mattsousaa/projeto_revELA/03_esquematicos_circuitos/01_projetoCompleto.PDF

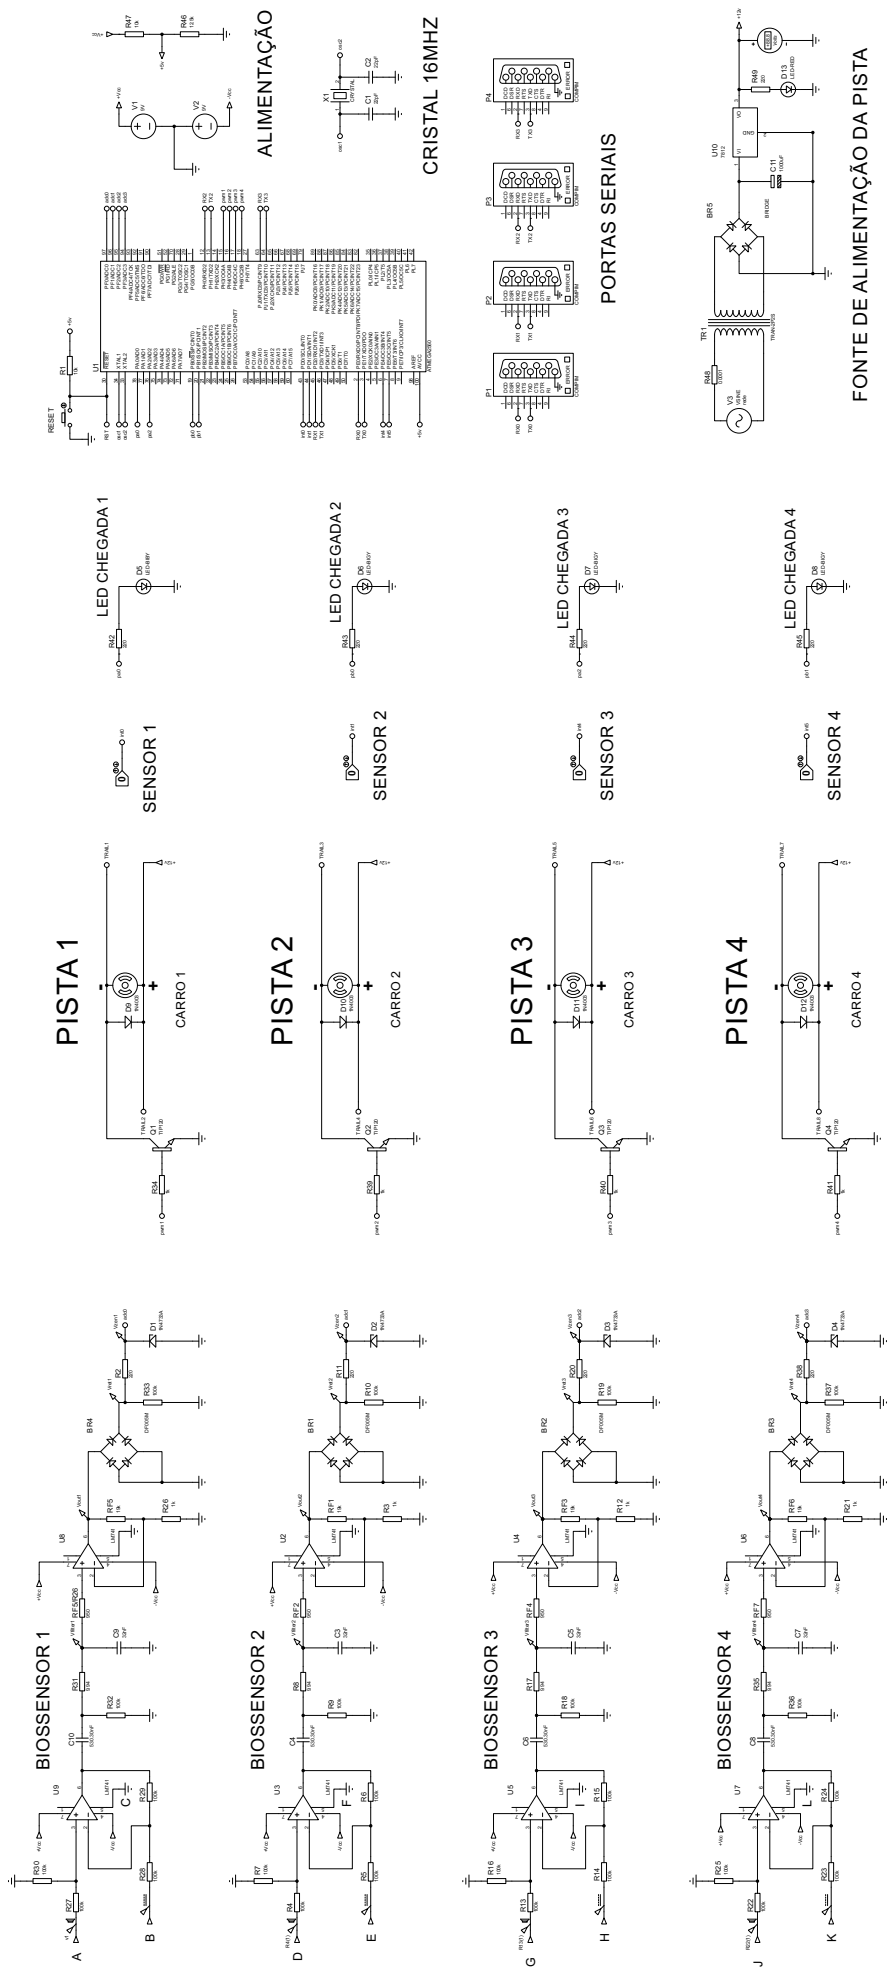
[picture p34: page 1]
