mattsousaa/projeto_revELA/03_esquematicos_circuitos/02_projetoIndividual.PDF

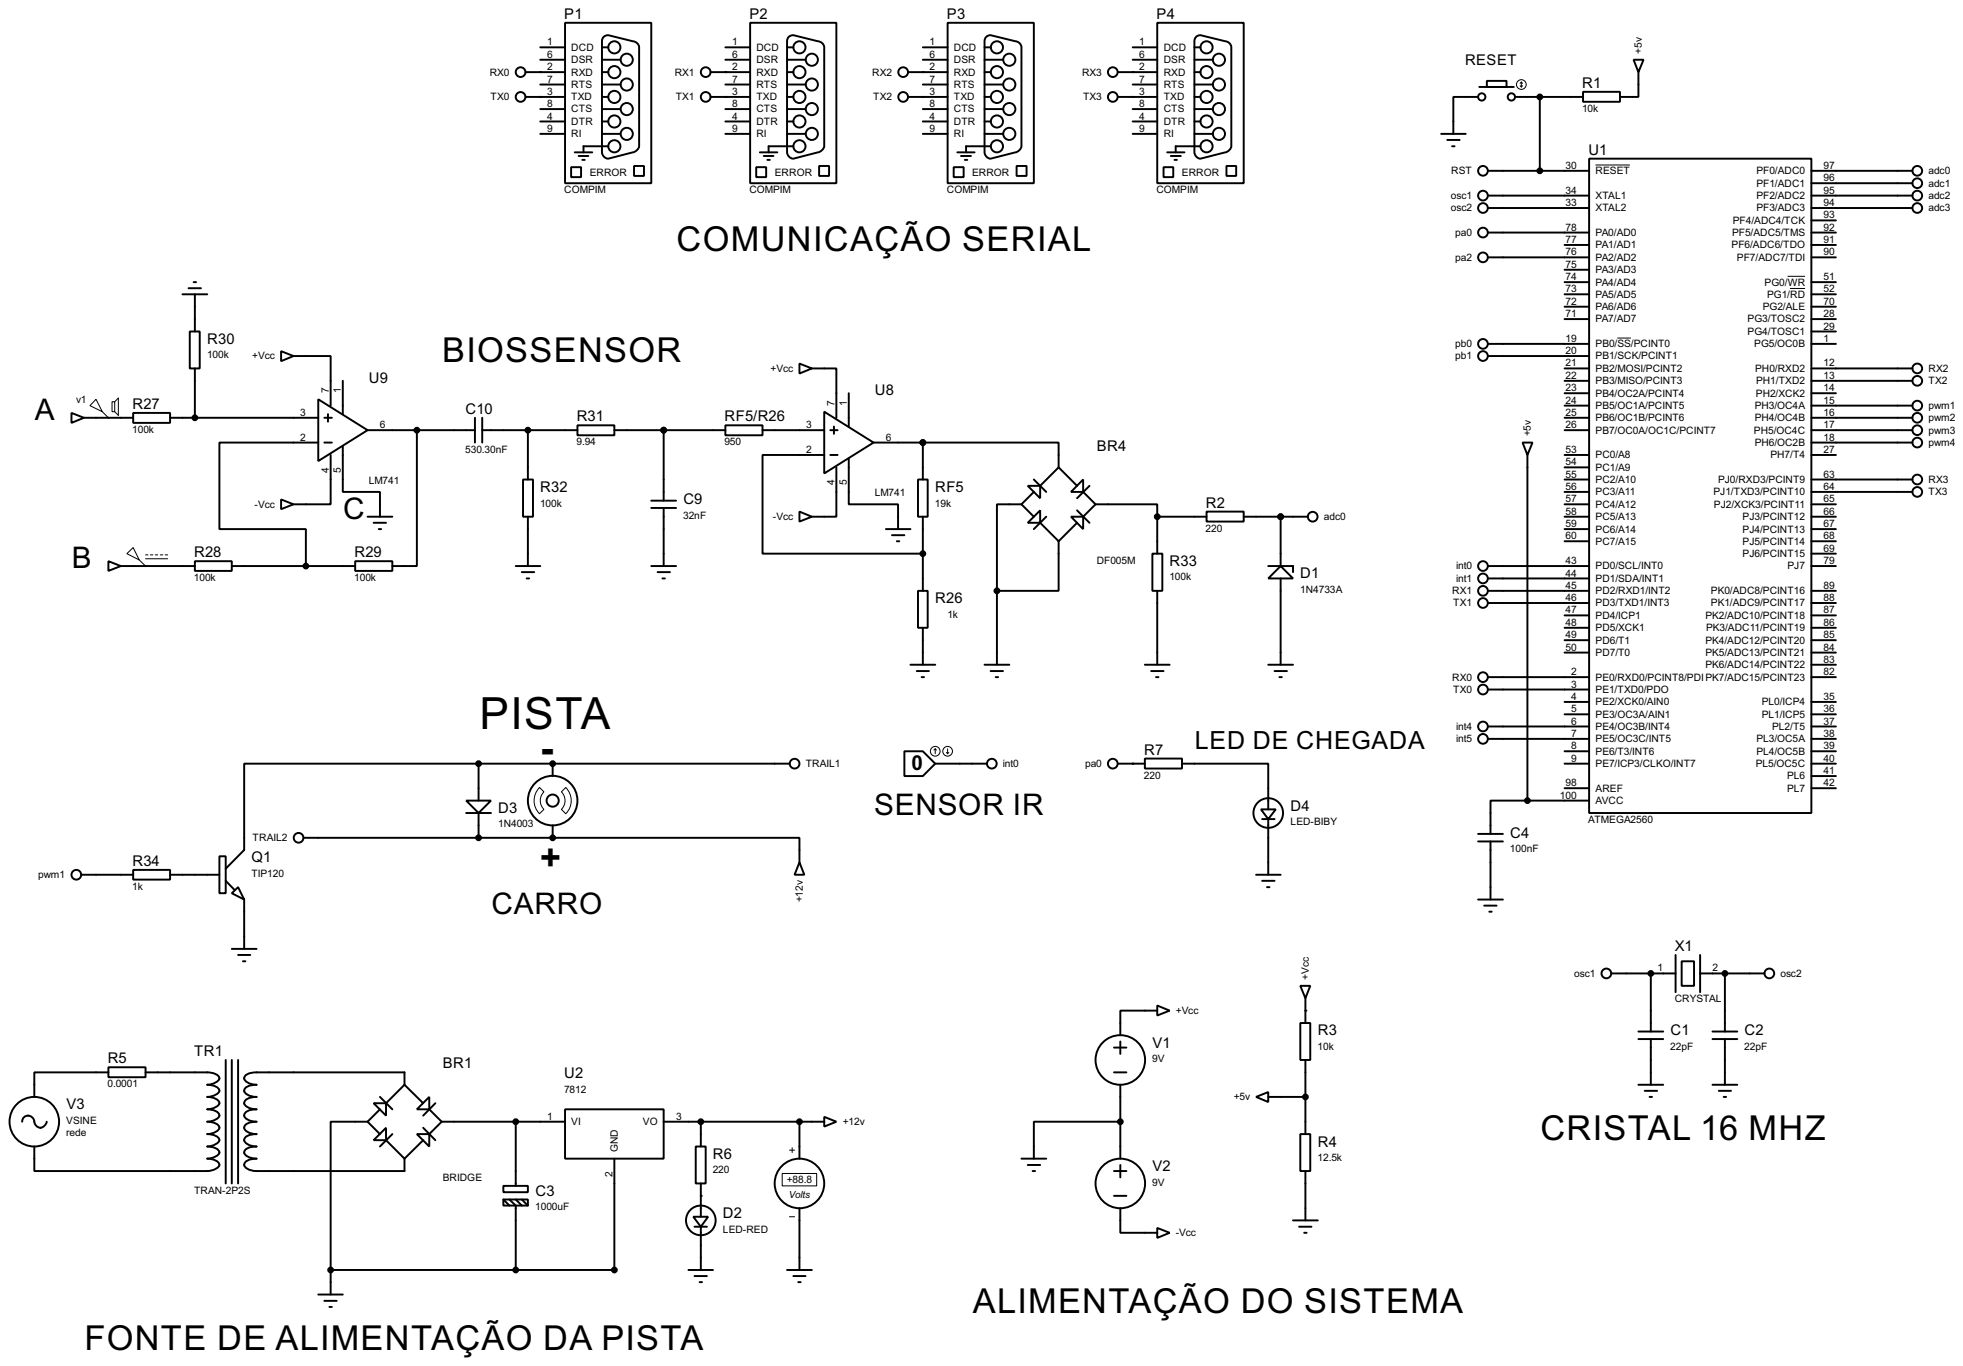
[picture p35: page 1]

FONTE DE ALIMENTAÇÃO DA PISTA
