mattsousaa/projeto_revELA/(list of files, drawings)

Other design files:
04_arquivos_proteus/01_projetoCompleto/teste_mega.pdsprj
04_arquivos_proteus/02_projetoPCB/EMG_PCB.pdsprj
